KNN-07/tessera-deck/hardware/out/assembly.step

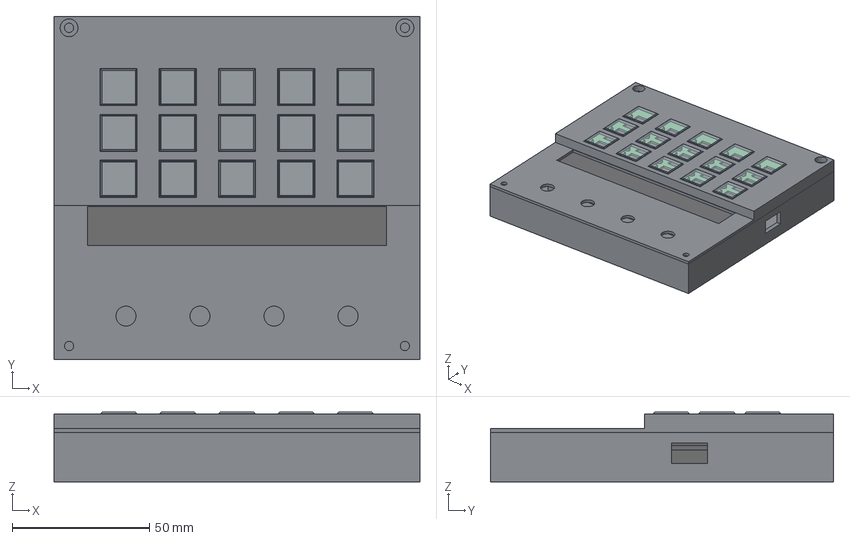
[picture p5: CAD file, 2026-11-10]
hardware/out/assembly.step
133.5 x 125.2 x 25.4 mm
tray
display
frame_pcb
cover
caps
