KNN-07/tessera-deck/hardware/out/keycap.step

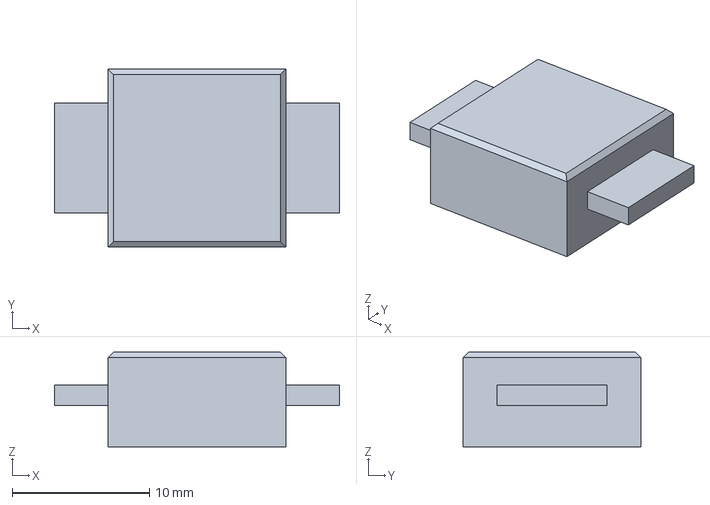
[picture p6: CAD file, 2026-11-10]
hardware/out/keycap.step
20.8 x 13.0 x 6.90 mm
