KNN-07/tessera-deck/hardware/out/key-frame-pcb.dxf

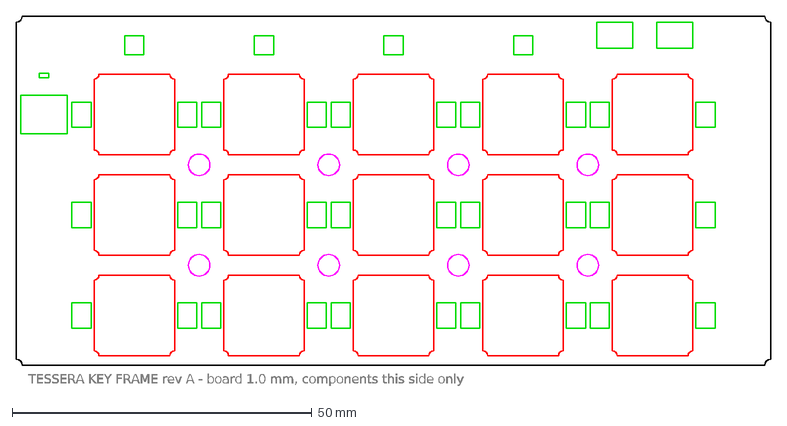
[picture p7: CAD file, 2026-11-10]
hardware/out/key-frame-pcb.dxf
TESSERA KEY FRAME rev A - board 1.0 mm, components this side only
