KNN-07/tessera-deck/hardware/out/encoder-pcb.dxf

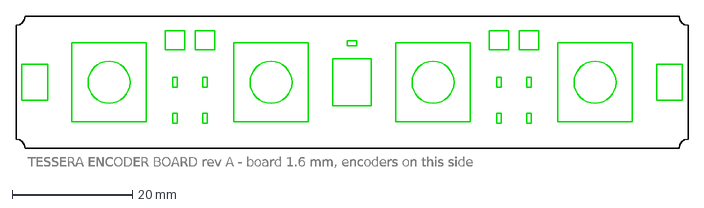
[picture p8: CAD file, 2026-11-10]
hardware/out/encoder-pcb.dxf
TESSERA ENCODER BOARD rev A - board 1.6 mm, encoders on this side
