KNN-07/tessera-deck/hardware/out/tray.step

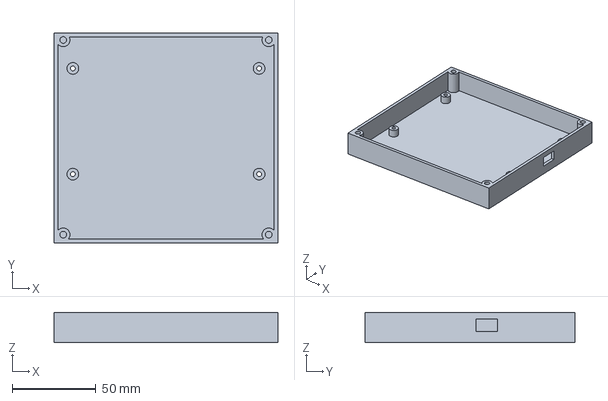
[picture p9: CAD file, 2026-11-10]
hardware/out/tray.step
133.5 x 125.2 x 18.0 mm
