KNN-07/tessera-deck/hardware/out/cover.step

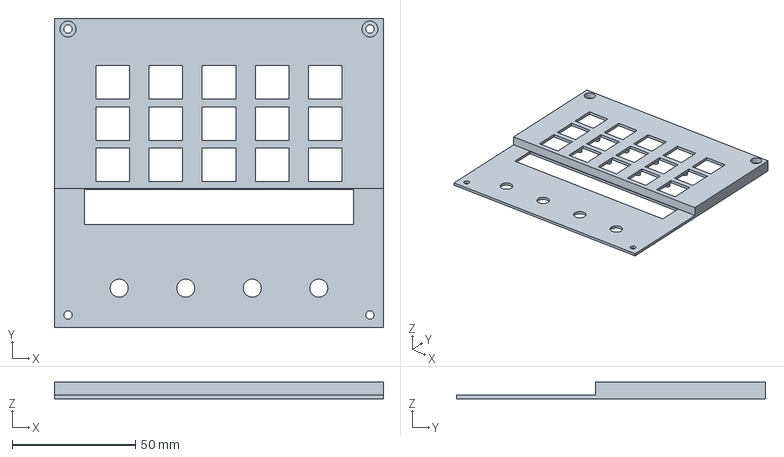
[picture p10: CAD file, 2026-11-10]
hardware/out/cover.step
133.5 x 125.2 x 6.80 mm
