KNN-07/tessera-deck/(list of files, cad)

Other CAD files:
hardware/out/cover.stl
hardware/out/keycap.stl
hardware/out/tray.stl
