KNN-07/tessera-deck/hardware/pcb/encoder/encoder.kicad_pcb

## KiCad design hardware/pcb/encoder/encoder.kicad_pcb (2026-11-10)

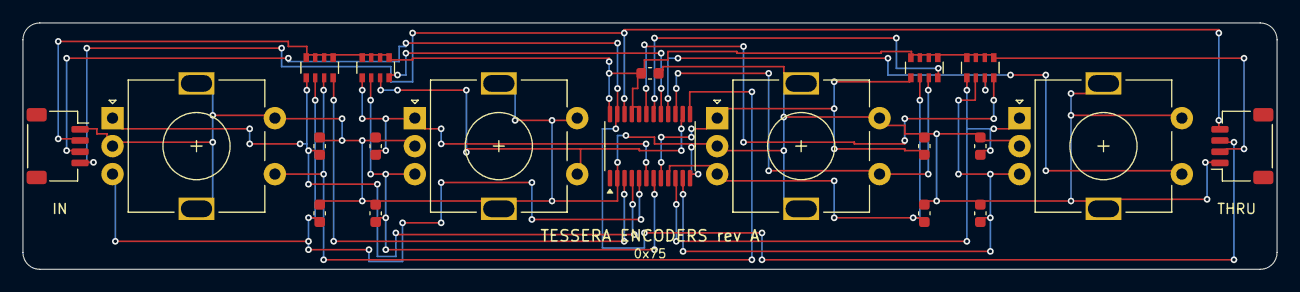
[picture p11: board encoder.kicad_pcb from above]

Board: 2 copper layers, 112.0 x 22.0 mm, 20 parts (0 on the bottom side), 20 nets.

Parts:
C2, C3, C4, C5, C6, C7, C8, C9: 10n; C_0603_1608Metric
C10: 100n; C_0603_1608Metric
ENC0, ENC1, ENC2, ENC3: EC11E; RotaryEncoder_Alps_EC11E-Switch_Vertical_H20mm
J3, J4: Qwiic; JST_SH_SM04B-SRSS-TB_1x04-1MP_P1.00mm_Horizontal
RN5, RN6, RN7, RN8: 4x10k; R_Array_Convex_4x0603
U2: TCA9539PWR; TSSOP-24_4.4x7.8mm_P0.65mm

Connections:
3V3: C10.1, J3.2, J4.2, RN5.5, RN5.6, RN5.7, RN5.8, RN6.5, RN6.6, RN6.7, RN6.8, RN7.5, RN7.6, RN7.7, RN7.8, RN8.5, RN8.6, RN8.7, RN8.8, U2.20, U2.21, U2.24
ENC0_A: C2.1, ENC0.A, RN5.1, U2.4
ENC0_B: C3.1, ENC0.B, RN5.2, U2.5
ENC0_SW: ENC0.S1, RN5.3, U2.13
ENC1_A: C4.1, ENC1.A, RN6.1, U2.6
ENC1_B: C5.1, ENC1.B, RN6.2, U2.7
ENC1_SW: ENC1.S1, RN6.3, U2.14
ENC2_A: C6.1, ENC2.A, RN7.1, U2.8
ENC2_B: C7.1, ENC2.B, RN7.2, U2.9
ENC2_SW: ENC2.S1, RN7.3, U2.15
ENC3_A: C8.1, ENC3.A, RN8.1, U2.10
ENC3_B: C9.1, ENC3.B, RN8.2, U2.11
ENC3_SW: ENC3.S1, RN8.3, U2.16
GND: C2.2, C3.2, C4.2, C5.2, C6.2, C7.2, C8.2, C9.2, C10.2, ENC0.C, ENC0.MP, ENC0.S2, ENC1.C, ENC1.MP, ENC1.S2, ENC2.C, ENC2.MP, ENC2.S2, ENC3.C, ENC3.MP, ENC3.S2, J3.1, J4.1, U2.2, U2.12
SCL: J3.4, J4.4, U2.22
SDA: J3.3, J4.3, U2.23
U2_P14: RN6.4, U2.17
U2_P15: RN7.4, U2.18
U2_P16: RN8.4, U2.19
U2_RESET: RN5.4, U2.3
