KNN-07/tessera-deck/hardware/pcb/key-frame/key-frame.kicad_pcb

## KiCad design hardware/pcb/key-frame/key-frame.kicad_pcb (2026-11-10)

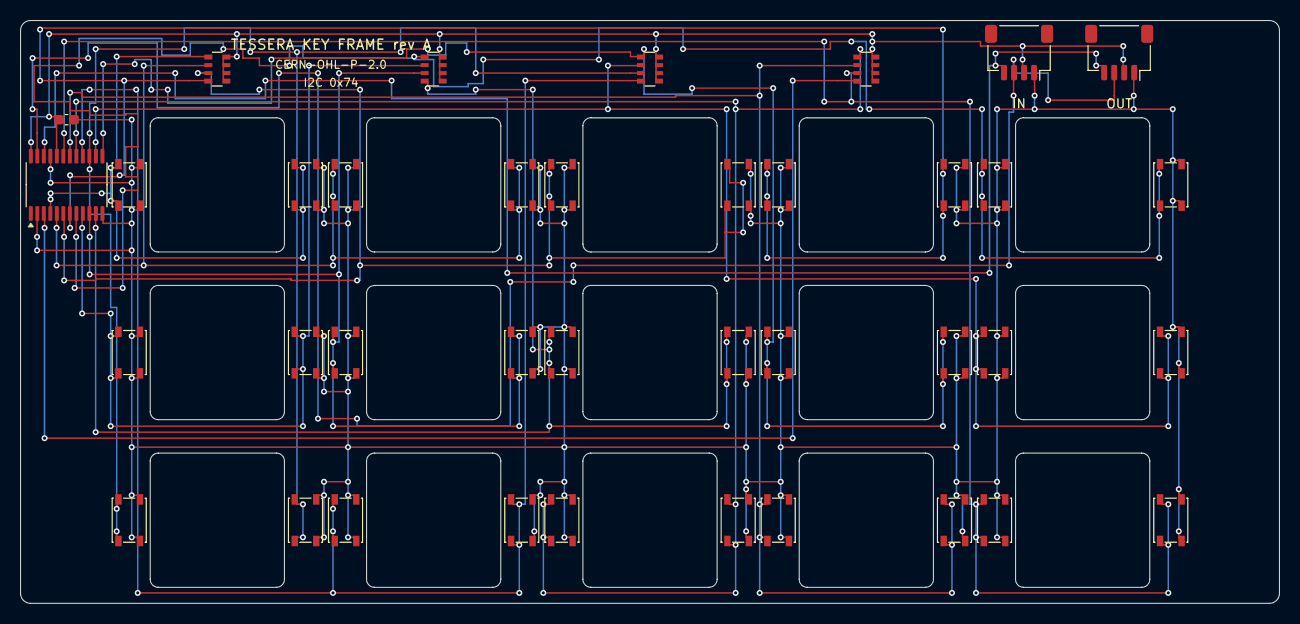
[picture p12: board key-frame.kicad_pcb from above]

Board: 2 copper layers, 125.7 x 58.2 mm, 38 parts (0 on the bottom side), 20 nets.

Parts:
C1: 100n; C_0603_1608Metric
J1, J2: Qwiic; JST_SH_SM04B-SRSS-TB_1x04-1MP_P1.00mm_Horizontal
RN1, RN2, RN3, RN4: 4x10k; R_Array_Convex_4x0603
SW0L, SW0R, SW1L, SW1R, SW2L, SW2R, SW3L, SW3R, SW4L, SW4R, SW5L, SW5R, SW6L, SW6R, SW7L, SW7R, SW8L, SW8R, SW9L, SW9R, SW10L, SW10R, SW11L, SW11R, SW12L, SW12R, SW13L, SW13R, SW14L, SW14R: PTS810 SJM 250; SW_SPST_PTS810
U1: TCA9539PWR; TSSOP-24_4.4x7.8mm_P0.65mm

Connections:
3V3: C1.1, J1.2, J2.2, RN1.5, RN1.6, RN1.7, RN1.8, RN2.5, RN2.6, RN2.7, RN2.8, RN3.5, RN3.6, RN3.7, RN3.8, RN4.5, RN4.6, RN4.7, RN4.8, U1.20, U1.24
GND: C1.2, J1.1, J2.1, SW0L.2, SW0R.2, SW1L.2, SW1R.2, SW2L.2, SW2R.2, SW3L.2, SW3R.2, SW4L.2, SW4R.2, SW5L.2, SW5R.2, SW6L.2, SW6R.2, SW7L.2, SW7R.2, SW8L.2, SW8R.2, SW9L.2, SW9R.2, SW10L.2, SW10R.2, SW11L.2, SW11R.2, SW12L.2, SW12R.2, SW13L.2, SW13R.2, SW14L.2, SW14R.2, U1.2, U1.12, U1.21
KEY0: RN1.1, SW0L.1, SW0R.1, U1.4
KEY1: RN1.2, SW1L.1, SW1R.1, U1.5
KEY2: RN1.3, SW2L.1, SW2R.1, U1.6
KEY3: RN1.4, SW3L.1, SW3R.1, U1.7
KEY4: RN2.1, SW4L.1, SW4R.1, U1.8
KEY5: RN2.2, SW5L.1, SW5R.1, U1.9
KEY6: RN2.3, SW6L.1, SW6R.1, U1.10
KEY7: RN2.4, SW7L.1, SW7R.1, U1.11
KEY8: RN3.1, SW8L.1, SW8R.1, U1.13
KEY9: RN3.2, SW9L.1, SW9R.1, U1.14
KEY10: RN3.3, SW10L.1, SW10R.1, U1.15
KEY11: RN3.4, SW11L.1, SW11R.1, U1.16
KEY12: RN4.1, SW12L.1, SW12R.1, U1.17
KEY13: RN4.2, SW13L.1, SW13R.1, U1.18
KEY14: RN4.3, SW14L.1, SW14R.1, U1.19
SCL: J1.4, J2.4, U1.22
SDA: J1.3, J2.3, U1.23
U1_RESET: RN4.4, U1.3
