KNN-07/tessera-deck/(commit log)

2026-11-10 Tessera Deck rev A: open-hardware macro deck with 15 LCD keys, 4 dials and a touch strip
    Firmware (portable core, ESP32-S3 port, PC simulator), the Tessera Deck
    Protocol, a Python library and CLI, an OpenDeck device plugin, and the
    hardware package: case and keycap CAD, PCB outlines, placement, netlists
    and BOM.
    Claude-Session: https://claude.ai/code/session_01R4j4f5FzN4MNAbyxCazEL5
    [assembly.step, bom.csv, cover.step, cover.stl, encoder-netlist.csv, encoder-pcb.dxf, encoder-placement.csv, key-frame-netlist.csv]
2026-11-10 Route both PCBs and add fabrication files
    Adds hardware/pcb: a script that builds the key frame and encoder boards
    in KiCad from the placement and netlist files, routes them with a small
    grid router, runs KiCad's DRC and exports Gerbers, drill files and
    pick-and-place positions. Both boards pass DRC with no violations and no
    unconnected pads.
    Placement changes that routing forced:
    - key frame: the port expander moves to the margin left of the first key
    column and the pull-up arrays spread along the top strip
    - encoder board: passives share the gaps between encoders instead of
    overlapping the port expander and connectors; connectors face the short
    edges
    CI now re-checks the committed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
    [assembly.step, bom.csv, cover.step, encoder-pcb.dxf, encoder-placement.csv, encoder-positions.csv, encoder.kicad_pcb, key-frame-pcb.dxf]
